gtrpucp/TapirChipDSPIC/docs/Schematics/Camera/Camera_Schematic.png

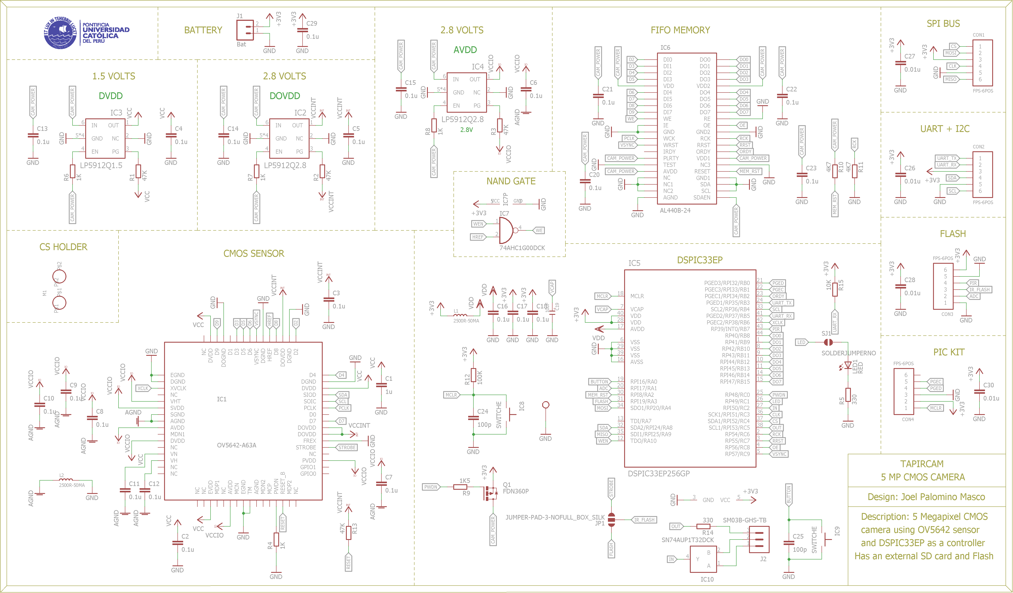
docs/Schematics/Camera/Camera_Schematic.png
