gtrpucp/TapirChipDSPIC/docs/Schematics/Camera/Flash_Schematic.png

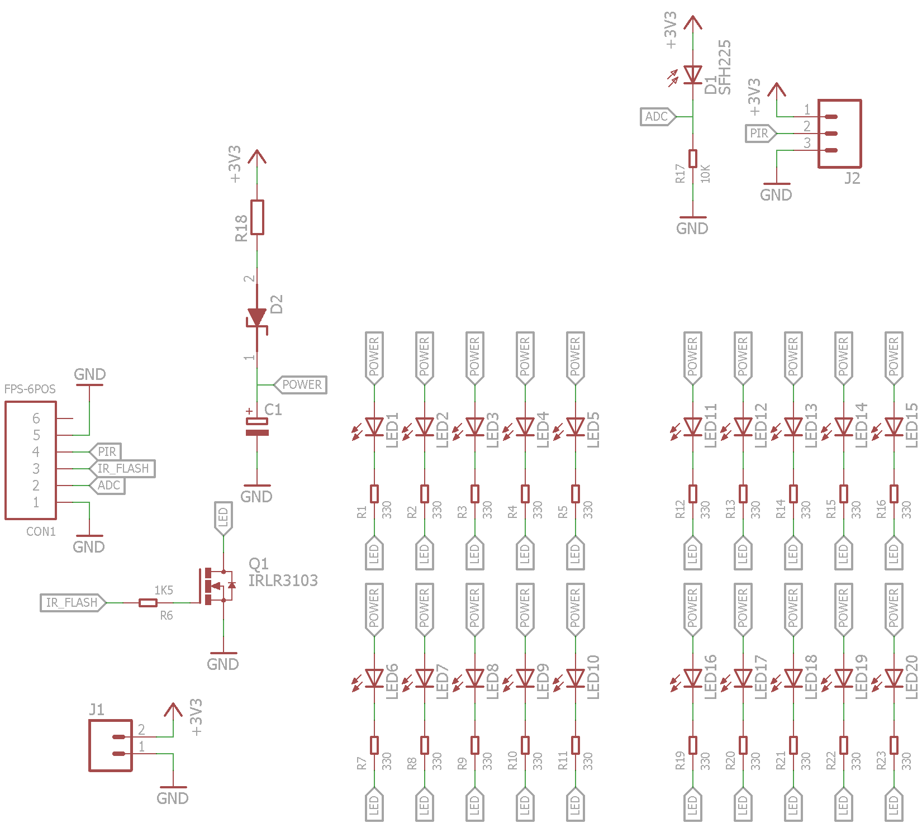
docs/Schematics/Camera/Flash_Schematic.png
