gtrpucp/TapirChipDSPIC/docs/Schematics/Camera/SD_Card_Schematic.png

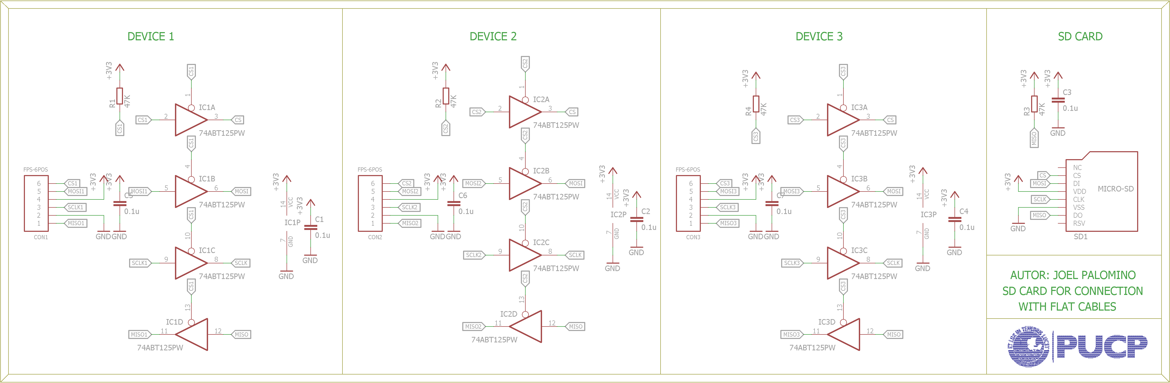
docs/Schematics/Camera/SD_Card_Schematic.png
