gtrpucp/TapirChipDSPIC/docs/Schematics/Camera/Sensors_Schematic.png

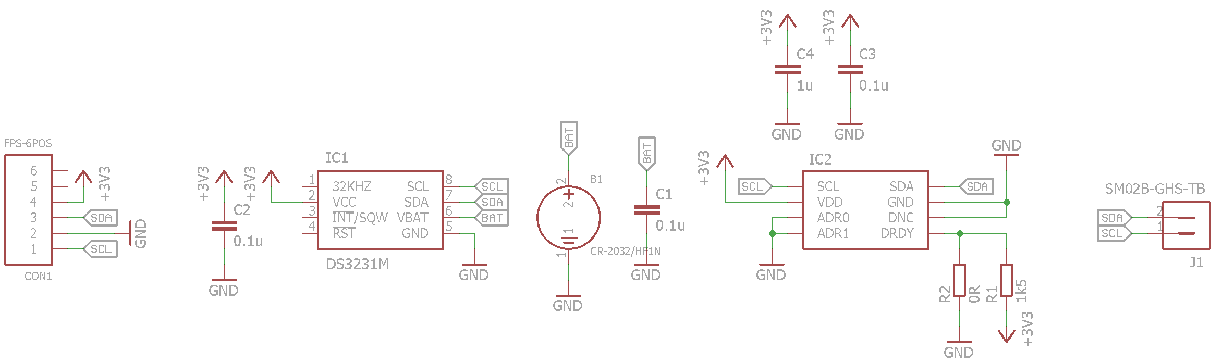
docs/Schematics/Camera/Sensors_Schematic.png
