gtrpucp/TapirChipDSPIC/docs/Schematics/Mp3Recorder/Audio_schematic.png

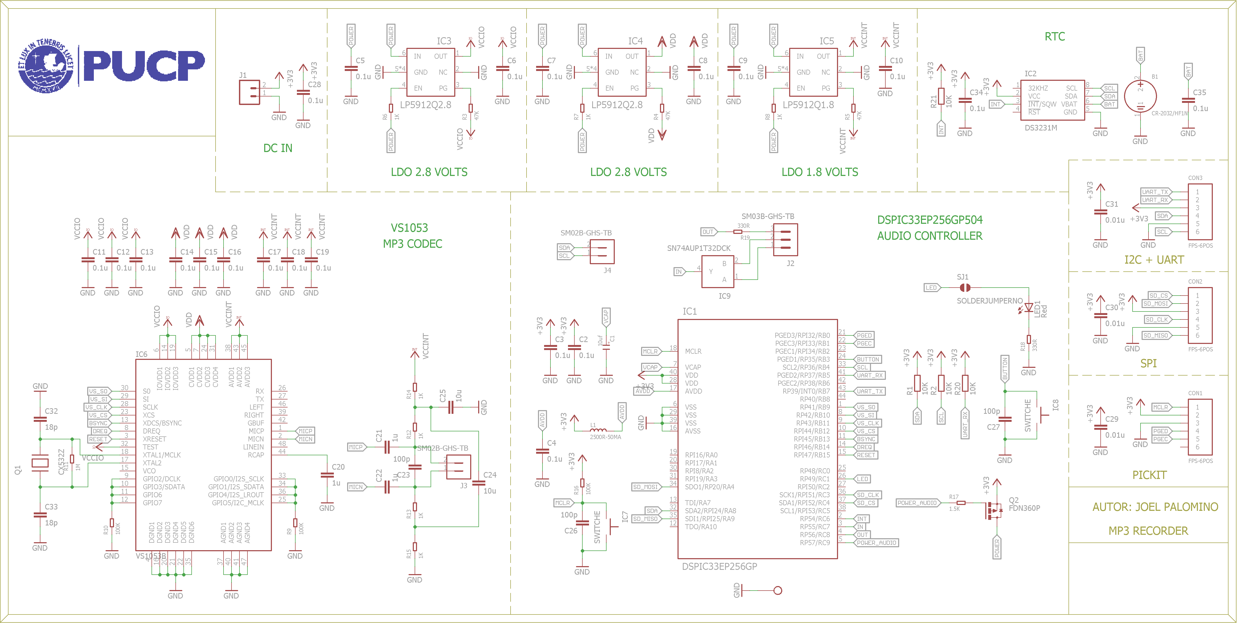
docs/Schematics/Mp3Recorder/Audio_schematic.png
