gtrpucp/TapirChipDSPIC/docs/Schematics/Radio/ESP8266_Schematic.png

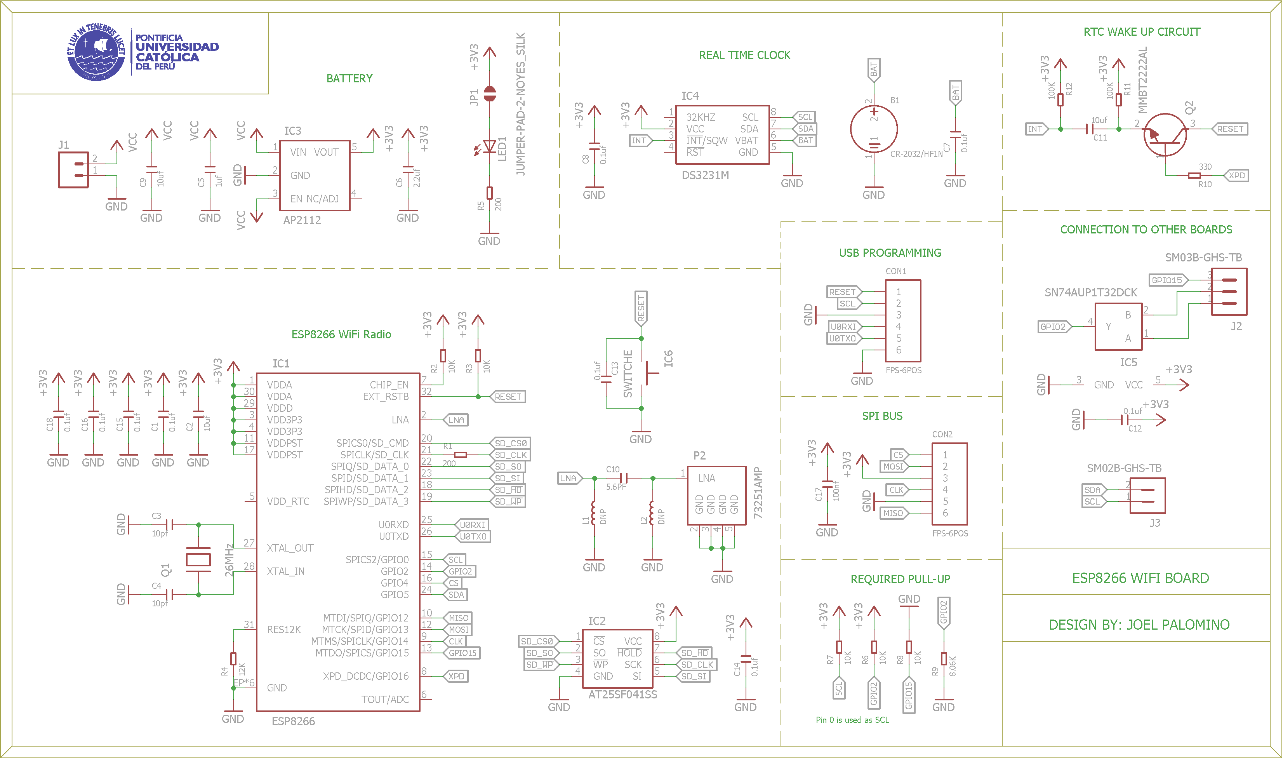
docs/Schematics/Radio/ESP8266_Schematic.png
