gtrpucp/TapirChipDSPIC/CameraTrapCode_OV5642_dsPIC33/arducam.h

/* 
 * File:   arducam.h
 * Author: HENDRIX
 *
 * Created on 29 de abril de 2016, 01:07 PM
 */

#ifndef ARDUCAM_H
#define	ARDUCAM_H

#define OV5642_CHIPID_HIGH 0x300a
#define OV5642_CHIPID_LOW 0x300b

const struct sensor_reg OV5642_VGA_preview_setting[] = 
{

	{0x3103 ,0x93},
	{0x3008 ,0x82},
	{0x3017 ,0x7f},
	{0x3018 ,0xfc},
	{0x3810 ,0xc2},
	{0x3615 ,0xf0},
	{0x3000 ,0x00},
	{0x3001 ,0x00},
	{0x3002 ,0x5c},
	{0x3003 ,0x00},
	{0x3004 ,0xff},
	{0x3005 ,0xff},
	{0x3006 ,0x43},
	{0x3007 ,0x37},
	{0x3011 ,0x08},
	{0x3010 ,0x10},
	{0x460c ,0x22},
	{0x3815 ,0x04},
	{0x370c ,0xa0},
	{0x3602 ,0xfc},
	{0x3612 ,0xff},
	{0x3634 ,0xc0},
	{0x3613 ,0x00},
	{0x3605 ,0x7c},
	{0x3621 ,0x09},
	{0x3622 ,0x60},
	{0x3604 ,0x40},
	{0x3603 ,0xa7},
	{0x3603 ,0x27},
	{0x4000 ,0x21},
	{0x401d ,0x22},
	{0x3600 ,0x54},
	{0x3605 ,0x04},
	{0x3606 ,0x3f},
	{0x3c01 ,0x80},
	{0x5000 ,0x4f},
	{0x5020 ,0x04},
	{0x5181 ,0x79},
	{0x5182 ,0x00},
	{0x5185 ,0x22},
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
	//;LENS
	{0x5800 ,0x48},
	{0x5801 ,0x31},
	{0x5802 ,0x21},
	{0x5803 ,0x1b},
	{0x5804 ,0x1a},
	{0x5805 ,0x1e},
	{0x5806 ,0x29},
	{0x5807 ,0x38},
	{0x5808 ,0x26},
	{0x5809 ,0x17},
	{0x580a ,0x11},
	{0x580b ,0xe },
	{0x580c ,0xd },
	{0x580d ,0xe },
	{0x580e ,0x13},
	{0x580f ,0x1a},
	{0x5810 ,0x15},
	{0x5811 ,0xd },
	{0x5812 ,0x8 },
	{0x5813 ,0x5 },
	{0x5814 ,0x4 },
	{0x5815 ,0x5 },
	{0x5816 ,0x9 },
	{0x5817 ,0xd },
	{0x5818 ,0x11},
	{0x5819 ,0xa },
	{0x581a ,0x4 },
	{0x581b ,0x0 },
	{0x581c ,0x0 },
	{0x581d ,0x1 },
	{0x581e ,0x6 },
	{0x581f ,0x9 },
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
	{0x3a1f ,0x10},
	{0x5688 ,0xfd},
	{0x5689 ,0xdf},
	{0x568a ,0xfe},
	{0x568b ,0xef},
	{0x568c ,0xfe},
	{0x568d ,0xef},
	{0x568e ,0xaa},
	{0x568f ,0xaa},
	
	{0x4740,0x21},
	{0x501e,0x2a},
	{0x5002,0xf8},
	{0x501f,0x01},
	{0x4300,0x61},

	{0xffff,0xff},
};        





#endif	/* ARDUCAM_H */
