gtrpucp/TapirChipDSPIC/CameraTrapCode_OV5642_dsPIC33/fuses.h

/* 
 * File:   fuses.h
 * Author: HENDRIX
 *
 * Created on 22 de marzo de 2016, 04:33 PM
 */

#ifndef FUSES_H
#define	FUSES_H


// DSPIC33EP256GP504 Configuration Bit Settings

// 'C' source line config statements

#include <xc.h>

// FICD
#pragma config ICS = PGD3               // ICD Communication Channel Select bits (Communicate on PGEC3 and PGED3)
#pragma config JTAGEN = OFF             // JTAG Enable bit (JTAG is disabled)

// FPOR
#pragma config ALTI2C1 = OFF            // Alternate I2C1 pins (I2C1 mapped to SDA1/SCL1 pins)
#pragma config ALTI2C2 = OFF             // Alternate I2C2 pins (I2C2 mapped to SDA2/SCL2 pins)
#pragma config WDTWIN = WIN25           // Watchdog Window Select bits (WDT Window is 25% of WDT period)

// FWDT
//#pragma config WDTPOST = PS32768        // Watchdog Timer Postscaler bits (1:32,768)
#pragma config WDTPOST = PS1024        // Watchdog Timer Postscaler bits (1:4,096)
#pragma config WDTPRE = PR128           // Watchdog Timer Prescaler bit (1:128)
#pragma config PLLKEN = ON              // PLL Lock Enable bit (Clock switch to PLL source will wait until the PLL lock signal is valid.)
#pragma config WINDIS = OFF             // Watchdog Timer Window Enable bit (Watchdog Timer in Non-Window mode)
#pragma config FWDTEN = OFF             // Watchdog Timer Enable bit (Watchdog timer enabled/disabled by user software)

// FOSC
#pragma config POSCMD = NONE            // Primary Oscillator Mode Select bits (Primary Oscillator disabled)
#pragma config OSCIOFNC = ON            // OSC2 Pin Function bit (OSC2 is general purpose digital I/O pin)
#pragma config IOL1WAY = OFF            // Peripheral pin select configuration (Allow multiple reconfigurations)
#pragma config FCKSM = CSDCMD           // Clock Switching Mode bits (Both Clock switching and Fail-safe Clock Monitor are disabled)

// FOSCSEL
#pragma config FNOSC = FRCPLL           // Oscillator Source Selection (Fast RC Oscillator with divide-by-N with PLL module (FRCPLL) )
#pragma config IESO = OFF               // Two-speed Oscillator Start-up Enable bit (Start up with user-selected oscillator source)

// FGS
#pragma config GWRP = OFF               // General Segment Write-Protect bit (General Segment may be written)
#pragma config GCP = OFF                // General Segment Code-Protect bit (General Segment Code protect is Disabled)

#endif	/* FUSES_H */
