gtrpucp/TapirChipDSPIC/(commit log)

2017-04-12 First codes of the trap camera
    This files are the code for the trap camera. Additional files explaining
    the functionality will be added
2017-04-27 Minor Fixes in the snapshot code
    Changed the write clock of the FIFO memory to a slower value to allow
    the processor to read correctly the data. Increased the time between
    pictures, so that the DSPIC processor can find the VSYNC signal
    [Camara.c, main.c]
2017-04-27 Added Camera Board Schematics files
    This schematic files show the camera module construccion
2017-04-27 Added Radio Schematic files
    This files show the connections of the radio module
2017-04-27 Added Audio schematic files
    This files show the connection of the radio module components
2017-04-28 Added Time Out in Main Loop
    This timeout will put the radio to sleep when it doesn´t find the slave
    device
    [MASTERTestingLibr.ino]
